rashmikanaveen/Smart-River-Water-Level-Monitoring-and-Alert-System/assets/schematic diagrams/Gateway Unit Schematic.png

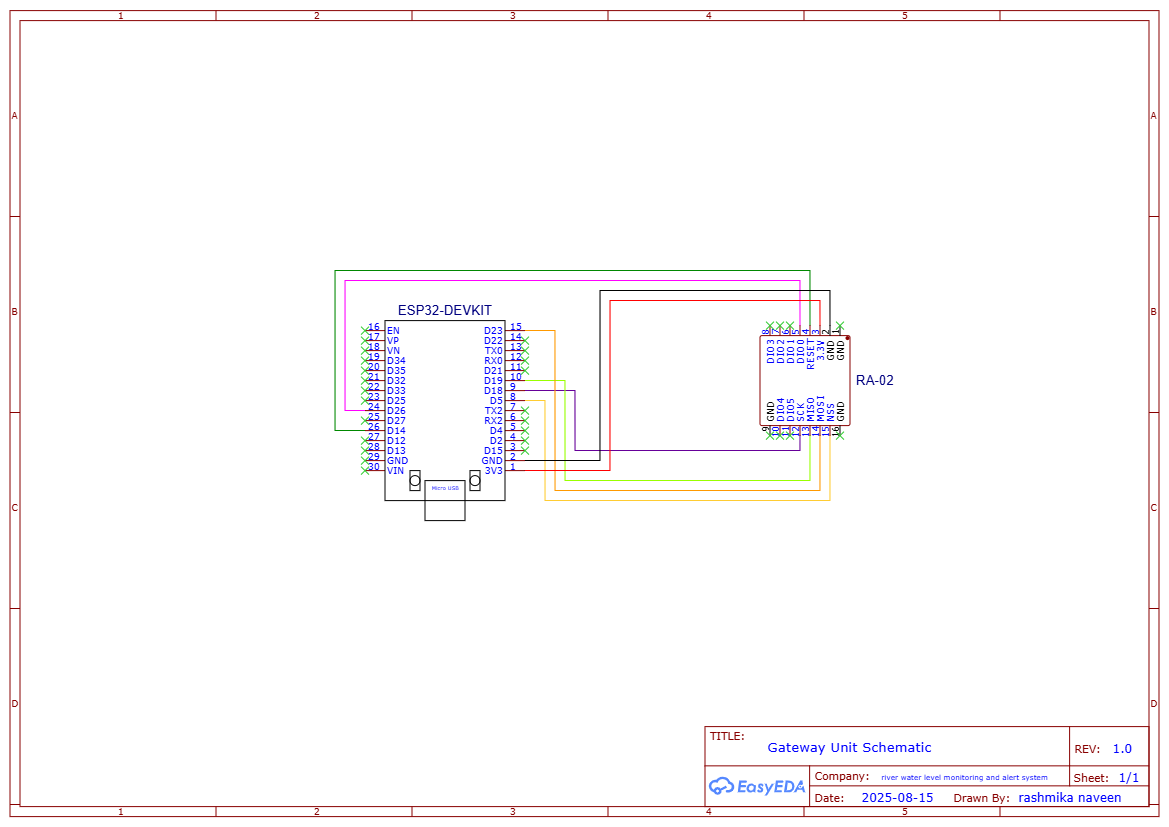
assets/schematic diagrams/Gateway Unit Schematic.png
