rashmikanaveen/Smart-River-Water-Level-Monitoring-and-Alert-System/assets/schematic diagrams/Sensor Unit Schematic.png

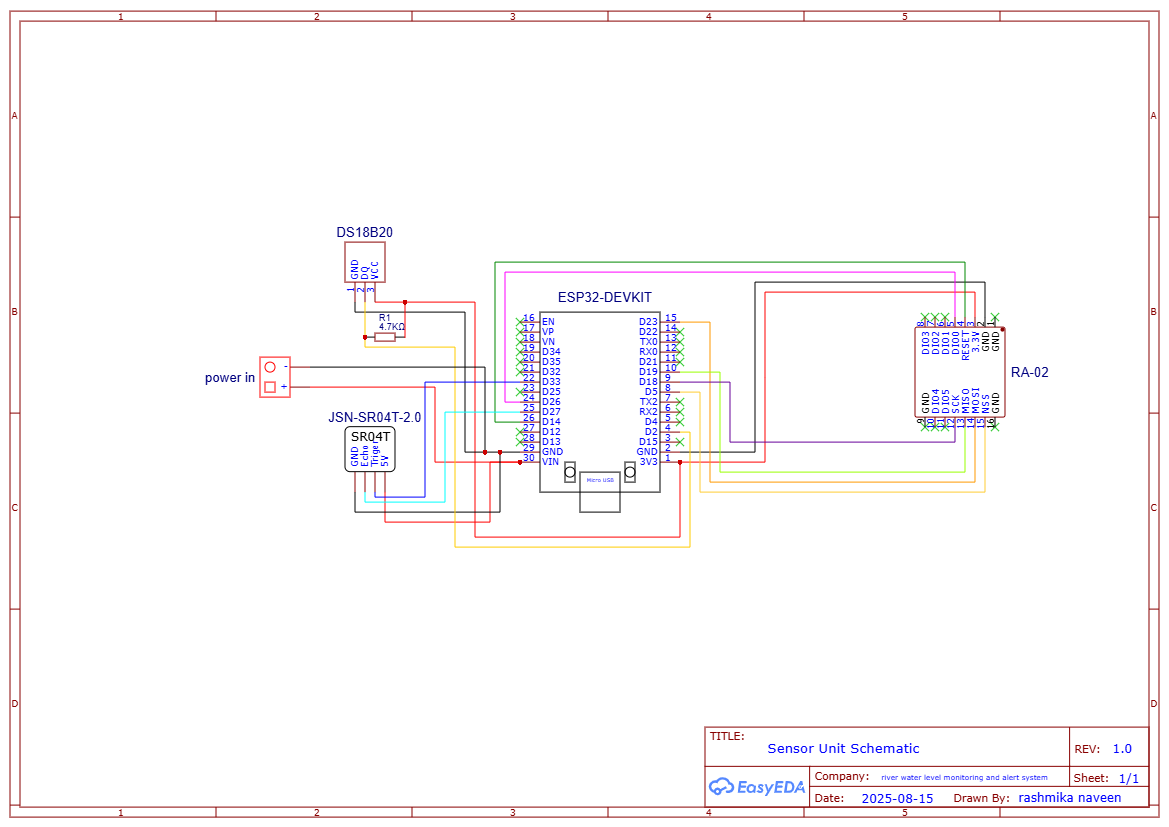
assets/schematic diagrams/Sensor Unit Schematic.png
