rashmikanaveen/Smart-River-Water-Level-Monitoring-and-Alert-System/assets/Assembled Circuit on Dot Board/Gateway Unit.png

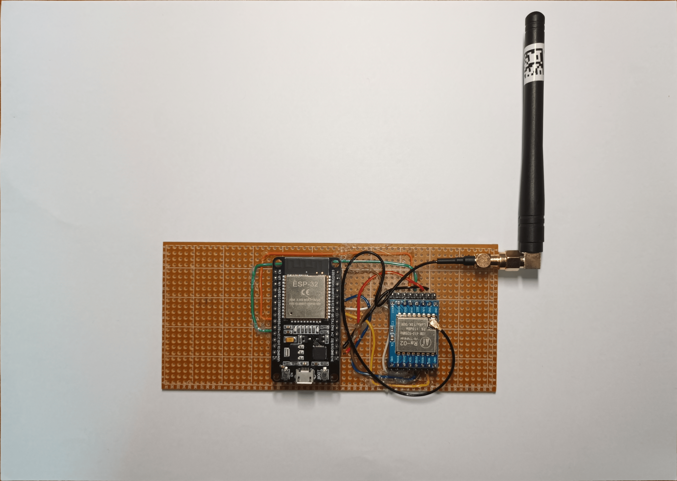
assets/Assembled Circuit on Dot Board/Gateway Unit.png
