rashmikanaveen/Smart-River-Water-Level-Monitoring-and-Alert-System/assets/Assembled Circuit on Dot Board/Sensor Unit.jpg

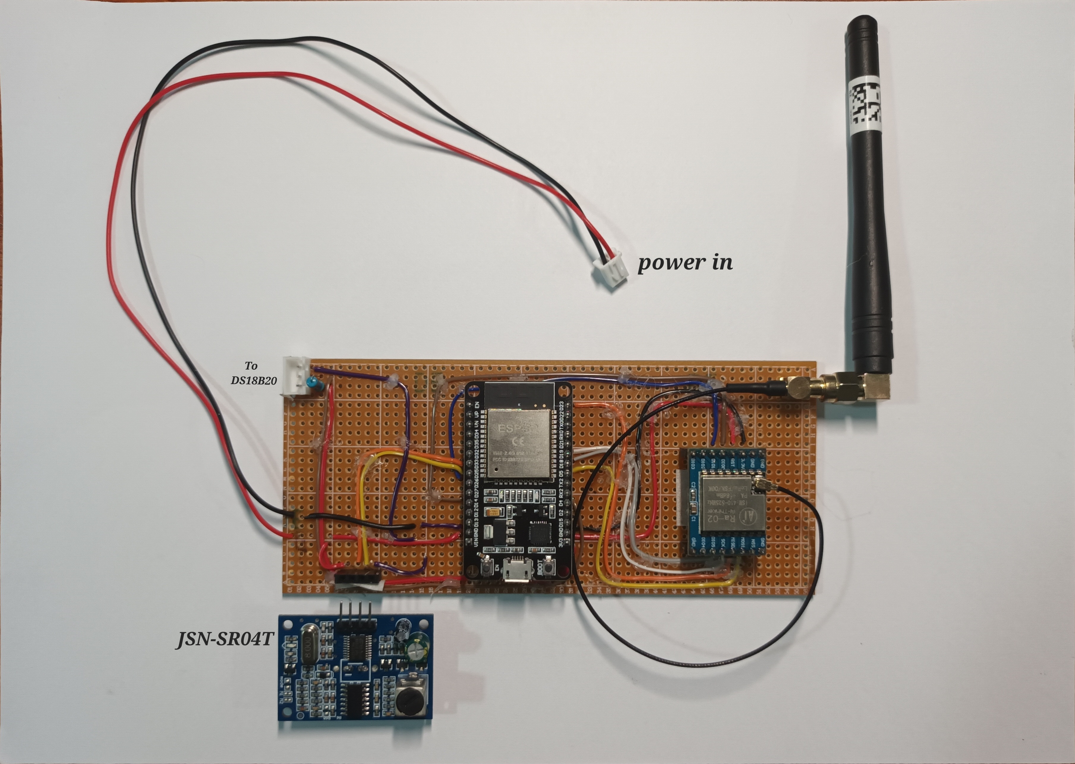
assets/Assembled Circuit on Dot Board/Sensor Unit.jpg
