rashmikanaveen/Smart-River-Water-Level-Monitoring-and-Alert-System/assets/LoRaTest1.jpg

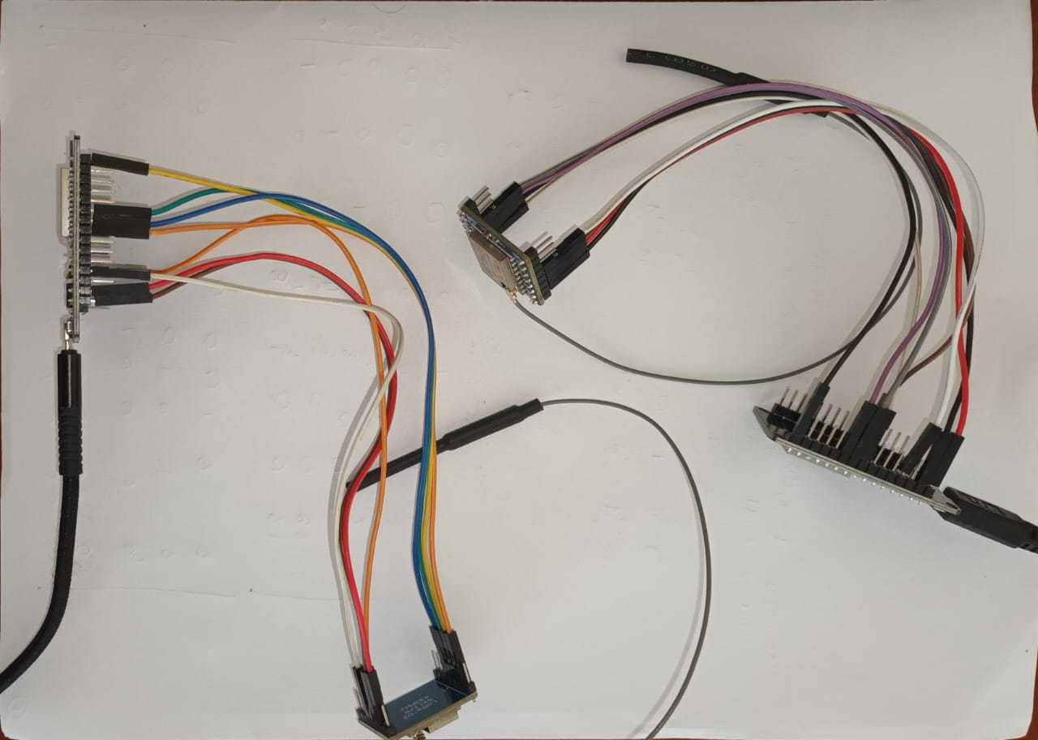
assets/LoRaTest1.jpg
