rashmikanaveen/Smart-River-Water-Level-Monitoring-and-Alert-System/assets/Real Environment Deployment Test/database screenshot.png

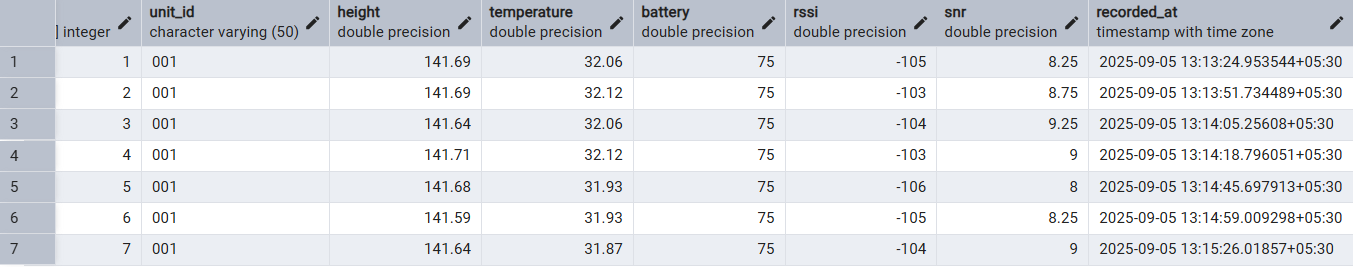
assets/Real Environment Deployment Test/database screenshot.png
