rashmikanaveen/Smart-River-Water-Level-Monitoring-and-Alert-System/assets/Real Environment Deployment Test/graphs/Distance_1.png

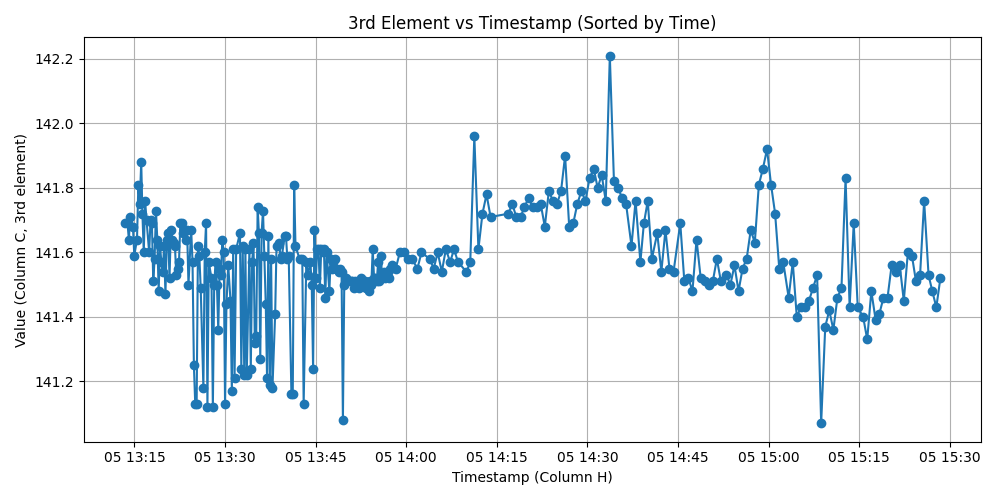
assets/Real Environment Deployment Test/graphs/Distance_1.png
