rashmikanaveen/Smart-River-Water-Level-Monitoring-and-Alert-System/assets/Real Environment Deployment Test/graphs/Temp_DIstance.png

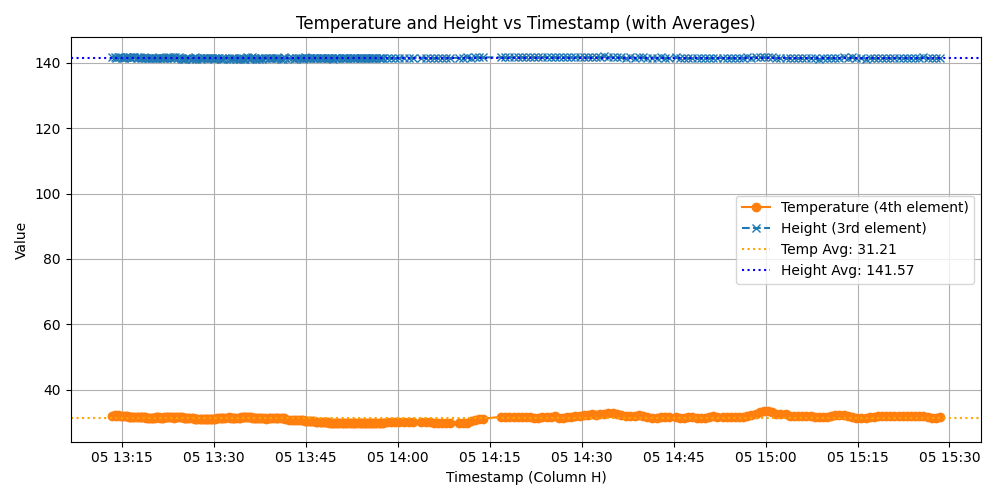
assets/Real Environment Deployment Test/graphs/Temp_DIstance.png
