rashmikanaveen/Smart-River-Water-Level-Monitoring-and-Alert-System/assets/Real Environment Deployment Test/unit fixed in the river 2.jpg

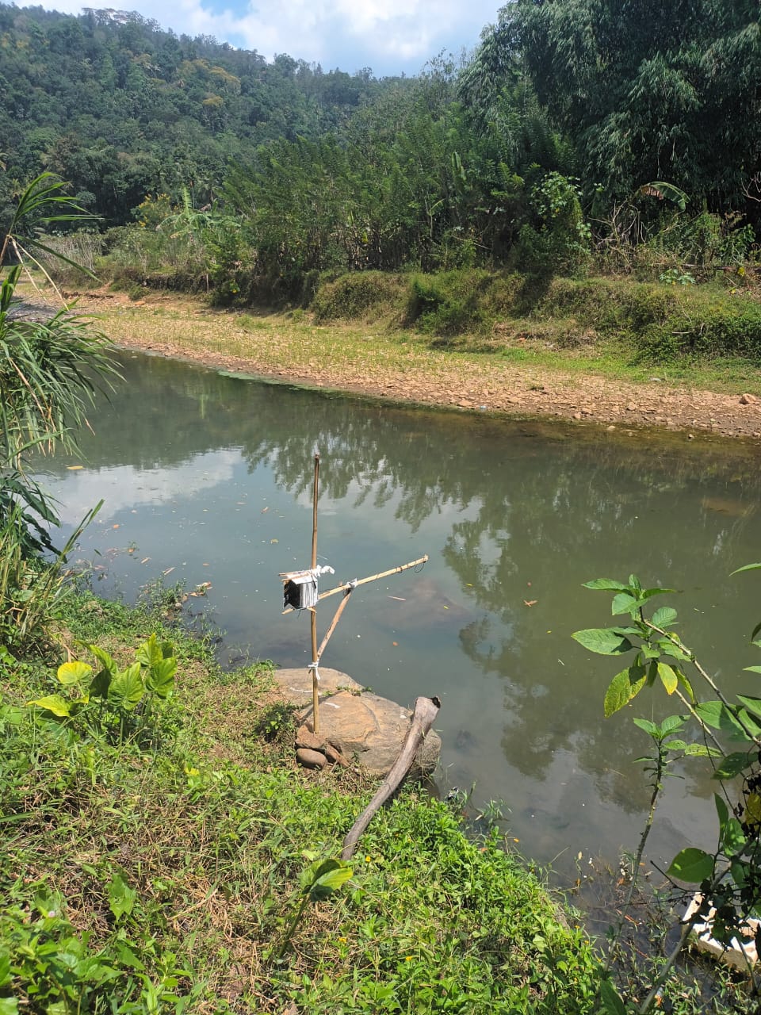
assets/Real Environment Deployment Test/unit fixed in the river 2.jpg
