rashmikanaveen/Smart-River-Water-Level-Monitoring-and-Alert-System/assets/Real Environment Deployment Test/unit.jpg

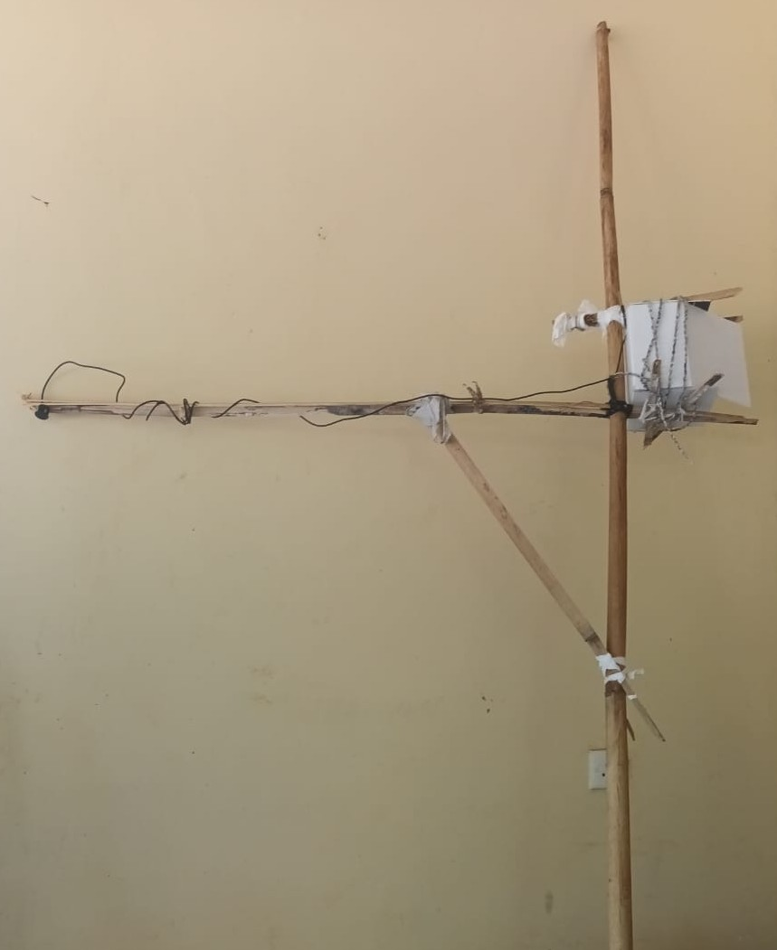
assets/Real Environment Deployment Test/unit.jpg
