rashmikanaveen/Smart-River-Water-Level-Monitoring-and-Alert-System/assets/Sensor Integration ‐ Ultrasonic Temperature Test.png

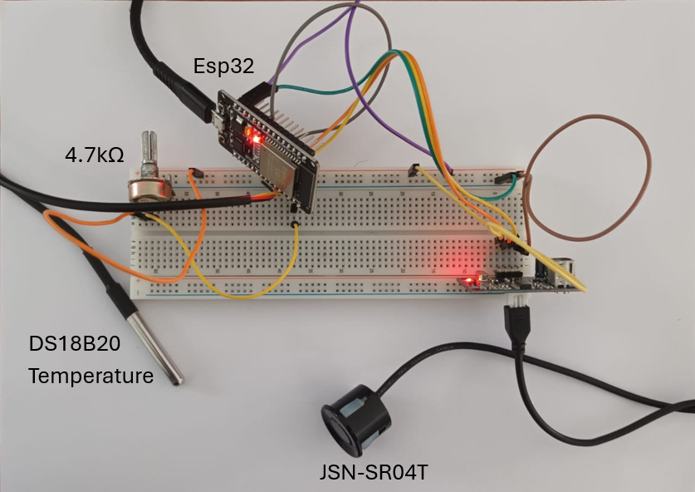
assets/Sensor Integration ‐ Ultrasonic Temperature Test.png
