rashmikanaveen/Smart-River-Water-Level-Monitoring-and-Alert-System/assets/Water Tank Experiment/1.jpg

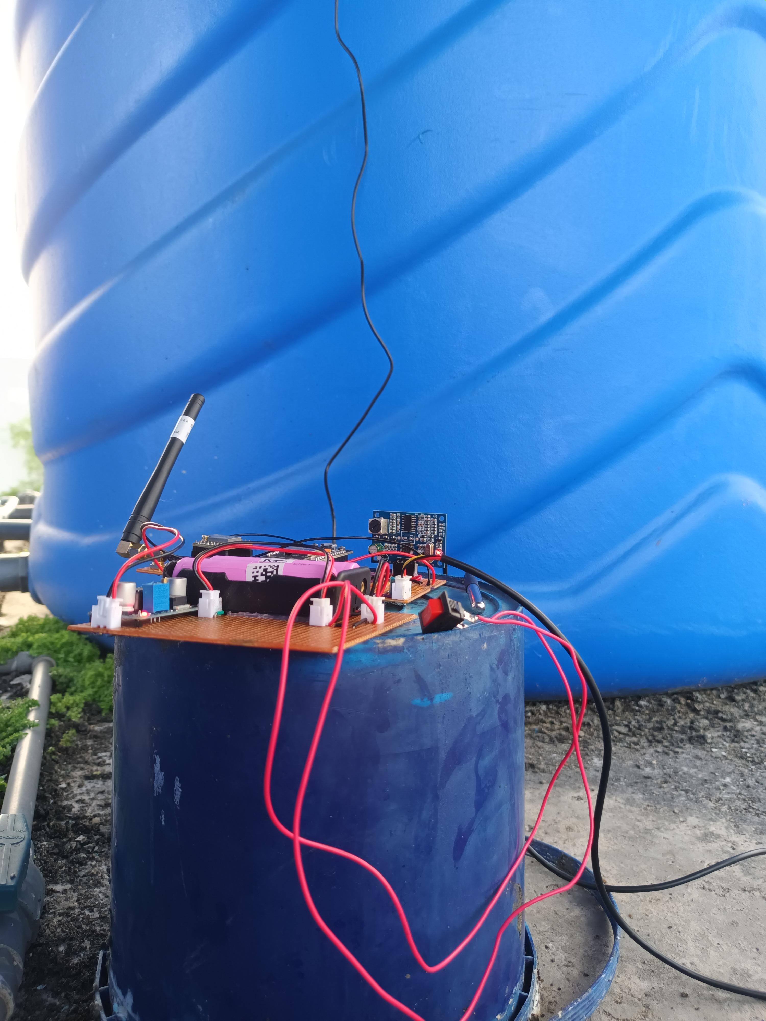
assets/Water Tank Experiment/1.jpg
