rashmikanaveen/Smart-River-Water-Level-Monitoring-and-Alert-System/assets/Water Tank Experiment/Screenshot 1.png

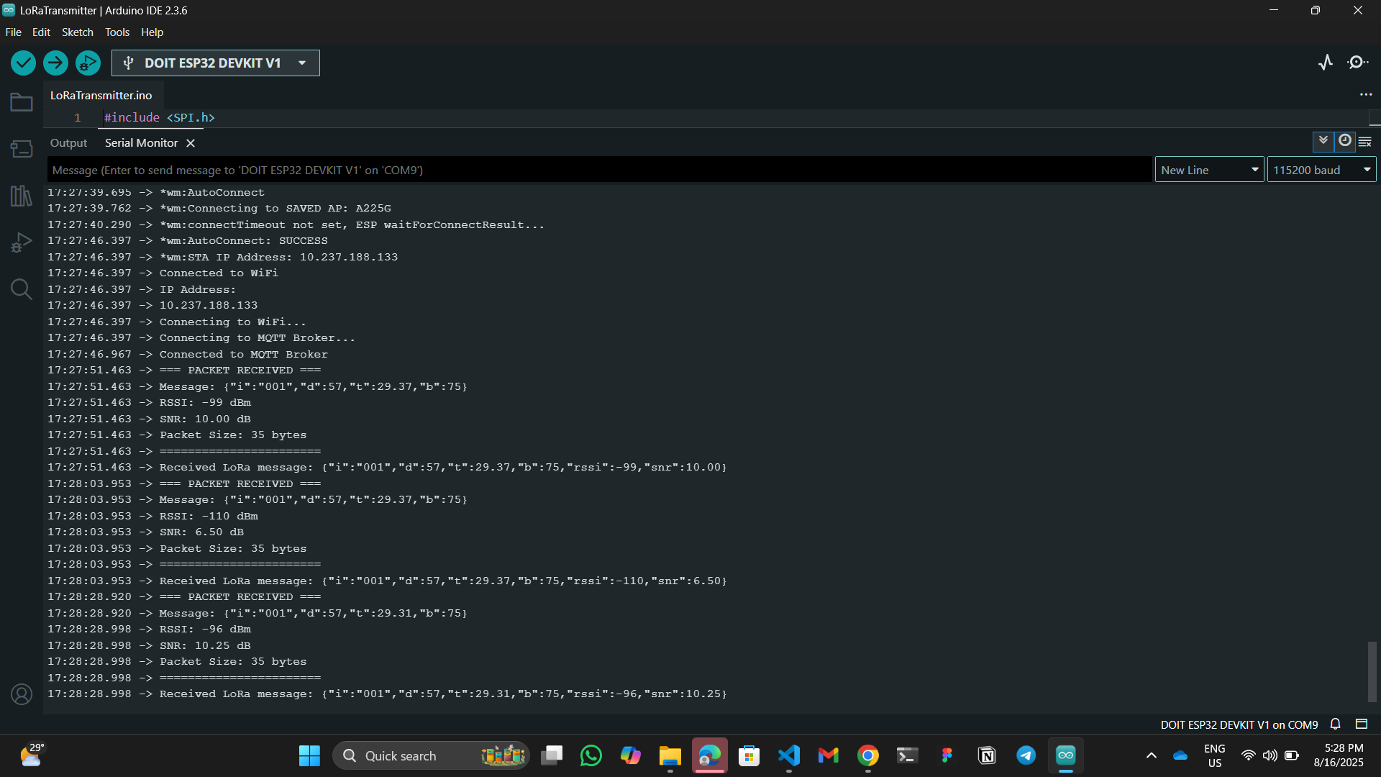
assets/Water Tank Experiment/Screenshot 1.png
