rashmikanaveen/Smart-River-Water-Level-Monitoring-and-Alert-System/assets/Problem & Motivation.png

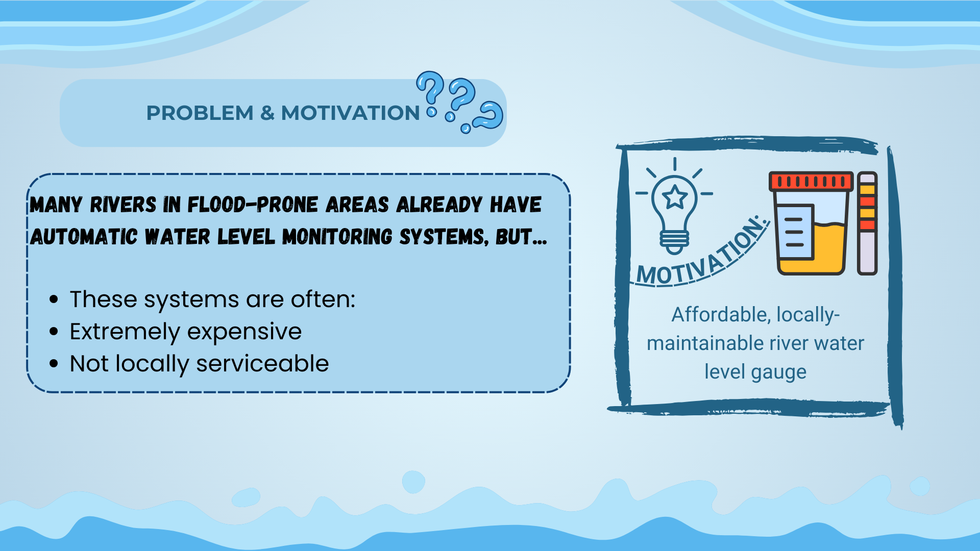
assets/Problem & Motivation.png
