rashmikanaveen/Smart-River-Water-Level-Monitoring-and-Alert-System/(threads)

Thread 5 (2025-07-24):

Create Wiki and github  Project  for track project

rashmikanaveen, 2025-07-24:
Create a well-structured project wiki to document all aspects of the water level monitoring system, including hardware details, firmware logic, system architecture, deployment, and troubleshooting. Additionally, write clear and detailed issue descriptions for all project tasks to be used on the project management board. This will help keep the team aligned, improve communication, and ensure smooth project progress.

Checklist:
 Design wiki folder structure and main pages

 Write content for each wiki page (Overview, Hardware, Firmware, etc.)

 Draft issue descriptions for all research and development tasks

 Assign labels and organize issues on the project board

 Link wiki pages from issues where relevant

Closed 2025-07-27.

Thread 7 (2025-07-24):

Test the basic functionality of each component separately

rashmikanaveen, 2025-07-24:
Test the basic functionality of each component separately (sensor readings, module connectivity). Prepare alternative options if issues arise.

Closed 2025-08-04.

Thread 14 (2025-08-04):

Setup MQTT Client to Receive Sensor Data

rashmikanaveen, 2025-08-04:
Implement MQTT client in the FastAPI backend to subscribe to relevant topics and receive sensor data.
Use gmqtt
Connect to the MQTT broker
Log/print incoming messages for debugging
Ensure proper reconnection handling

Closed 2025-08-31.

Thread 15 (2025-08-04):

Setup MQTT Client to Receive Sensor Data

rashmikanaveen, 2025-08-04:
Implement MQTT client in the FastAPI backend to subscribe to relevant topics and receive sensor data.
Use gmqtt
Connect to the MQTT broker
Log/print incoming messages for debugging
Ensure proper reconnection handling

Thread 18 (2025-08-04):

Test Real-Time Data Flow (MQTT → Server → WebSocket)

rashmikanaveen, 2025-08-04:
Write a basic test to simulate incoming MQTT messages and verify they’re pushed to a test WebSocket client.
Use node-red as mock MQTT message publisher
Use browser or WebSocket test client
Confirm real-time behavior

Closed 2025-08-04.

Thread 26 (2025-08-15):

Battery Circuit Design for Sensor Unit

rashmikanaveen, 2025-08-15:
Design and implement a reliable battery circuit for the sensor unit. Ensure proper voltage regulation and compatibility with the sensors.

Closed 2025-08-29.

Thread 30 (2025-08-15):

gateway unit Schematic

rashmikanaveen, 2025-08-15:
Check the gateway unit schematic for errors or improvements. Make sure all components are correctly connected and functional. use easy eda for schematic diagram

Closed 2025-08-16.

Thread 47 (2025-08-31):

Sensor Unit Enclosure

rashmikanaveen, 2025-08-31:
The sensor unit needs to be compact, weather-resistant, and low-power friendly, since it will be deployed near the river. so build Prototype

Closed 2025-08-31.
