rashmikanaveen/Smart-River-Water-Level-Monitoring-and-Alert-System/firmware/gateway-unit/src/mqtt.ino

#include "config.h"






void setupMQTT(){
  mqttClient.setServer("broker.hivemq.com", 1883);
  mqttClient.setCallback(receviveCallback);
  
}


void connectToBroker(){
  while(!mqttClient.connected()){
    Serial.println("Connecting to MQTT Broker...");
    if(mqttClient.connect("ESP32-rashmikanaveen")){
      Serial.println("Connected to MQTT Broker");
      //mqttClient.subscribe("rashmikanaveen");
      
    }else{
      Serial.print("Failed to connect, rc=");
      Serial.print(mqttClient.state());
      delay(500);
    }
  }
}

void receviveCallback(char* topic, byte* payload, unsigned int length) {
 
  Serial.print("Message arrived [");
  Serial.print(topic);
  Serial.print("] ");
  
  char payloadCharAr[length + 1]; // Add space for null terminator
  for (int i = 0; i < length; i++) {
    Serial.print((char)payload[i]);
    payloadCharAr[i] = (char)payload[i];
  }
  payloadCharAr[length] = '\0'; // Null-terminate the string
  Serial.println();
  
  //if (strcmp(topic, "rashmikanaveen-ts") == 0) {
  //  int value = atoi(payloadCharAr);
  //  ts=value;
  //}
  
}
  
