rashmikanaveen/Smart-River-Water-Level-Monitoring-and-Alert-System/firmware/test-cases/Temp_sensor/Temp_sensor.ino

#include <OneWire.h>
#include <DallasTemperature.h>

#define ONE_WIRE_BUS 4

OneWire oneWire(ONE_WIRE_BUS);
DallasTemperature sensors(&oneWire);

void setup() {
  Serial.begin(115200);
  sensors.begin();
}

void loop() {
  sensors.requestTemperatures(); // Trigger measurement

  float tempC = sensors.getTempCByIndex(0);
  if (tempC == DEVICE_DISCONNECTED_C) {
    Serial.println("Sensor not found 😥");
  } else {
    Serial.print("Temperature: ");
    Serial.print(tempC);
    Serial.println(" °C");
  }

  delay(1000);
}
