rashmikanaveen/Smart-River-Water-Level-Monitoring-and-Alert-System/(commit log)

2025-07-25 Add temperature sensor, WiFi management, and ultrasonic sensor test implementations
2025-07-25 Add initial project structure for gateway and sensor units, including configuration files, README documentation, and example code for LED control
2025-07-26 Refactor ultrasonic sensor test code for improved readability and performance; add temperature reading functionality with distance calculation adjustments.
2025-07-30 feat: add UI components for badge, button, card, dropdown menu, input, label, progress, and switch
    - Implemented Badge component with variants for different styles.
    - Created Button component with support for different sizes and variants.
    - Developed Card component with subcomponents for header, title, description, content, and footer.
    - Added DropdownMenu component with various items, triggers, and content handling.
    - Introduced Input component for user input with styling.
    - Created Label component for form labels with styling.
    - Implemented Progress component to visually represent progress.
    - Developed Switch component with customizable sizes and states.
    feat: create UnitCard component fo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
2025-08-03 Refactor: Remove unused Analytics and Map pages, streamline Dashboard
    - Deleted Analytics page and its associated components to simplify the application.
    - Removed Map page to focus on core functionalities.
    - Updated Dashboard page by removing the filter toggle for rising levels.
    - Adjusted Home page to redirect to Dashboard on load.
    - Enhanced Settings page with an "Add Unit" button and improved layout.
    - Cleaned up mock data by removing unnecessary unit entries.
    - Introduced WebSocket manager for real-time updates in the backend.
    - Added configuration and functionality for disabling WiFi and Bluetooth in firmware.
    - Implemented improved distance measurement and filtering in sensor unit.
2025-08-04 Bridge MQTT Data to WebSocket Clients and update frontend,etup MQTT Client to Receive Sensor Data
2025-08-11 Add JSON creation function for sensor data and update unit display to cm
2025-08-15 Implement temperature sensor functionality and update JSON creation for sensor data
2025-08-15 add schematic diagram photos for both sensor unit and gateway unit
2025-08-15 add images of Assembled Circuits on Dot Board
2025-08-16 update pictues of sensor unit
2025-08-28 Add timestamp to sensor data and implement database models for sensor measurements and units
2025-08-31 Implement Binary Protocol for Sensor Data Transmission
    - Added BinaryProtocol.h and BinaryProtocol.cpp to define the structure and functions for packing and unpacking sensor data in a binary format.
    - Integrated CRC-16 error detection for data integrity during transmission.
    - Updated sensor-unit and gateway-unit to utilize the new binary protocol for LoRa communication, replacing the previous JSON format.
    - Modified main.ino to send binary data instead of JSON, improving transmission efficiency.
    - Created BinaryProtocol_Diagrams.md to document the system architecture and data flow of the binary protocol.
    - Added README_BinaryProtocol.md to provide an overview of the binary protocol implement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
    [BinaryProtocol.cpp, BinaryProtocol.h, BinaryProtocolTest.ino, Lora.ino, config.h, main.ino]
2025-08-31 Enhance distance measurement functions with temperature compensation
2025-09-11 prototype of sensor unit stand
2025-10-18 Implement sensor measurement routes and daily averages calculation service
    - Added sensor_routes.py for handling sensor measurement requests.
    - Introduced DailyAverageDB model for storing daily averages.
    - Created DailyAveragesService for calculating and managing daily averages.
    - Implemented startup functions to calculate missing averages on system start.
    - Developed a daily scheduler for end-of-day average calculations.
2025-10-19 feat: Implement latest data caching for sensor units
    - Added a caching layer for the latest MQTT sensor data to improve retrieval speed and reduce database load.
    - Created new API endpoints to fetch latest data for specific units and all units.
    - Updated the frontend to utilize the new API structure and display real-time data.
    - Refactored unit context and websocket context to manage state and data flow more efficiently.
    - Enhanced unit card component to reflect real-time updates and status changes.
    - Introduced WebSocket wrapper for managing WebSocket connections across the application.
    - Updated types and interfaces to accommodate new data structures and alert levels.
