rashmikanaveen/Smart-River-Water-Level-Monitoring-and-Alert-System/assets/Water Tank Experiment/2.jpg

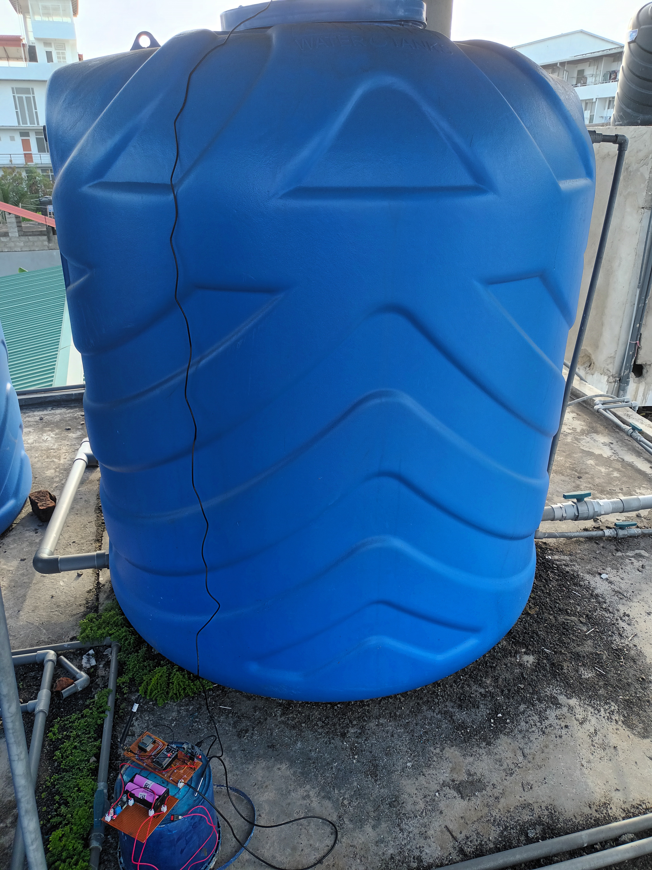
assets/Water Tank Experiment/2.jpg
